coddingtonbear/suzibot/hardware/suzie_bot.pdf

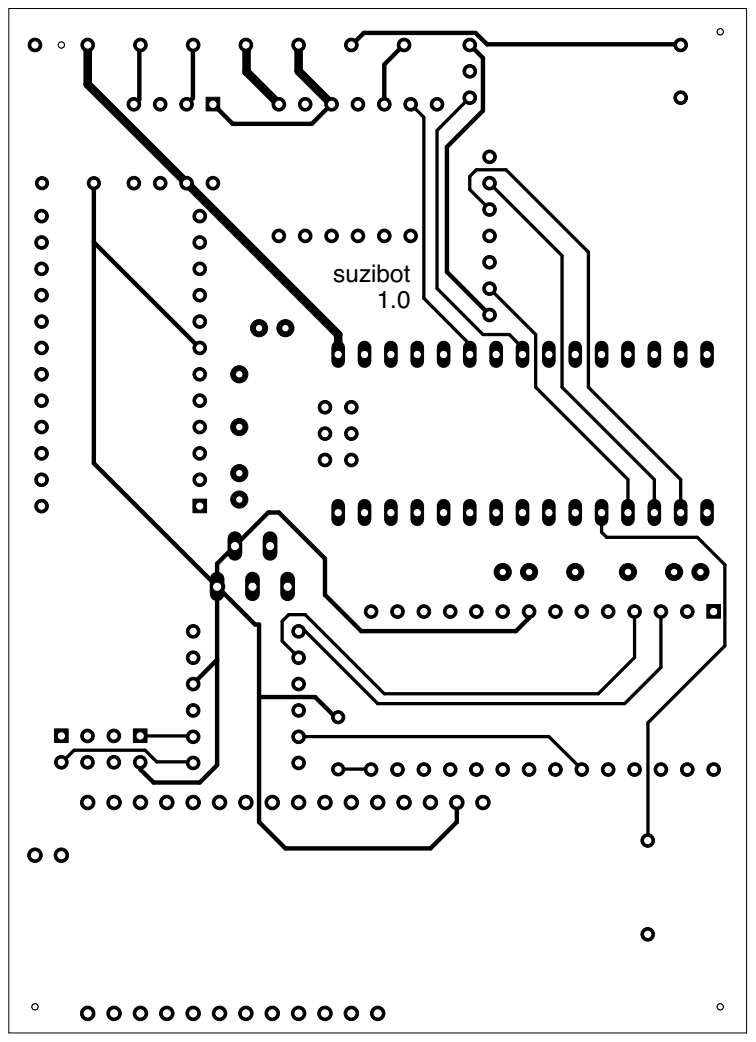
[picture p1: page 1]
