coddingtonbear/suzibot/hardware/suzie_bot_bottom.pdf

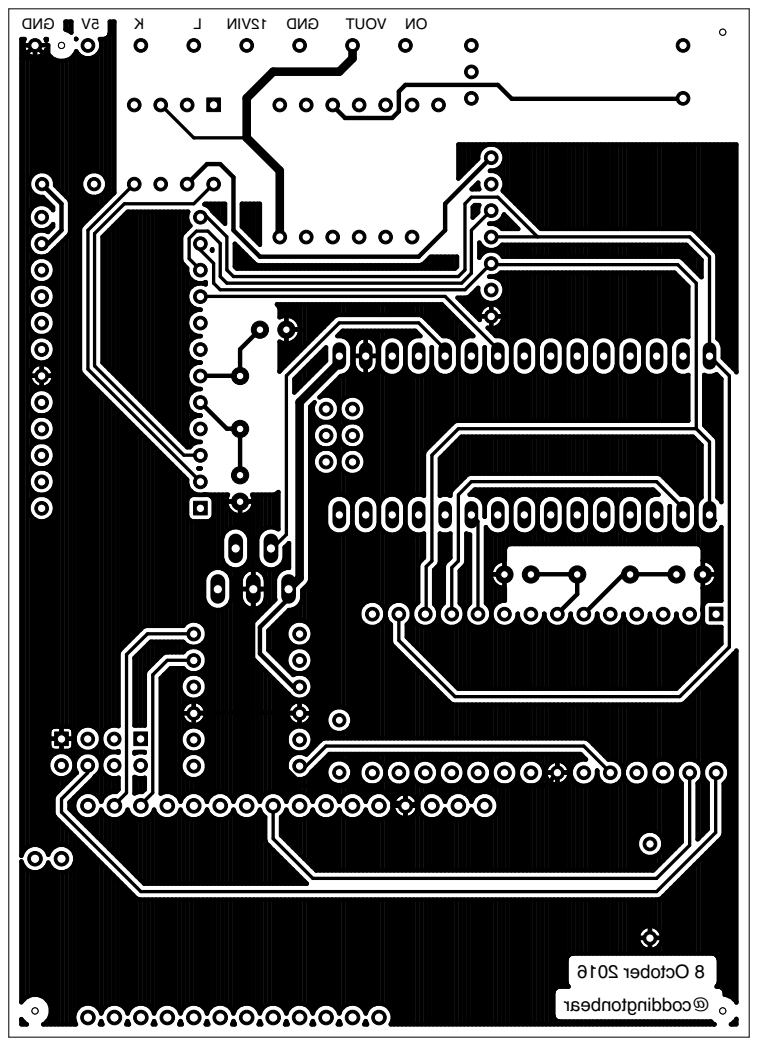
[picture p2: page 1]

DNG V5 K L NI V21 DNG TUOV NO
