coddingtonbear/suzibot/hardware/suzie_bot_top.pdf

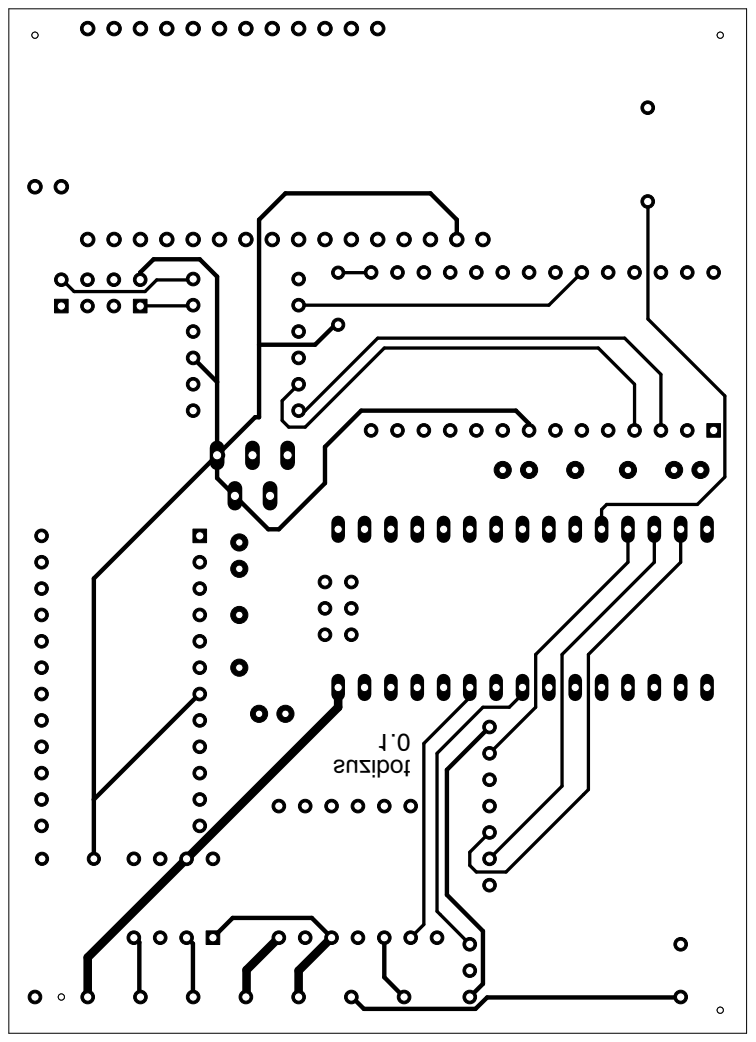
[picture p3: page 1]
