coddingtonbear/suzibot/hardware/shield/shield.kicad_pcb

## KiCad design hardware/shield/shield.kicad_pcb (2016-12-24)

Schematic: shield.sch

Parts:
C1, C2: 22p; C_0805_HandSoldering
C3: 0.01u; C_0805_HandSoldering
C4: 22u; C_Radial_D5_L6_P2.5
C5, C6, C7, C8: 0.1u; C_0805_HandSoldering
D1: ORANGE; LED_0805
D2: RED; LED_0805
D3: BLUE; LED_0805
E1: JNHUAMAO_HM-10; JNHUAMAO_26.9X13X2.2_BOARD
J10: USB_OTG; USB_Mini-B
JP1, JP2: Pin_Header_Straight_1x03
PA0, PA1: DP_DEVICES.V6_M1X8
PB0, PB1: DP_DEVICES.V6_M1X8
PC0, PC1: DP_DEVICES.V6_M1X8
PD0, PD1: DP_DEVICES.V6_M1X8
PROG0, PROG1: DP_DEVICES.V6_M1X6
PWR0, PWR1, PWR2, PWR3: DP_DEVICES.V6_M1X3
R1: 68; R_0805_HandSoldering
R2: 150; R_0805_HandSoldering
R3: 100; R_0805_HandSoldering
R4: DTR-RST; C_0805
R5: RTS-RST; C_0805
R6: 3V3USB; C_0805
SW1: RESET; NANO-SWITCH
U1: LM1117; SPARKFUN-POWERIC_SOT223
U2: 74LV4052; SOIC-16_3.9x9.9mm_Pitch1.27mm
U3: TXB0104; SOIC-14_3.9x8.7mm_Pitch1.27mm
U$1: CH340G_SOIC16
Y1: 12M; Crystal_HC49-U_Vertical

Connections:
/3V3: C7.1, E1.11 (RESET), E1.12 (+3.3V), JP1.1, JP2.1, R6.2, U1.2 (OUT), U1.4 (OUT), U3.1 (VA), U3.8 (OE)
/CONN-BT: E1.24 (LED), U3.5 (A4)
/D-: J10.2 (D-), U$1.6 (D-)
/DTR: PROG0.1, PROG1.1, R4.2, R5.2, SW1.1, U3.11 (B3)
/DTR-BT: E1.25 (PIO2), U3.4 (A3)
/DTR-USB: R4.1, U$1.13 (DTR)
/N$2: JP1.3, JP2.3, PWR0.2, PWR1.2, R1.1
/N$6: J10.1 (VBUS), PROG0.4, PROG1.4
/N$8: C3.2, R6.1, U$1.4 (V3)
/N$9: PD0.8, PD1.8
/N$10: PD0.7, PD1.7
/N$11: PD0.6, PD1.6
/N$12: PD0.5, PD1.5
/N$13: PD0.4, PD1.4
/N$14: PD0.3, PD1.3
/N$15: PD0.2, PD1.2
/N$16: PD0.1, PD1.1
/N$17: PC0.8, PC1.8
/N$18: PC0.7, PC1.7
/N$19: PC0.6, PC1.6
/N$20: PROG0.5, PROG1.5
/N$21: PC0.4, PC1.4, R3.2, U2.10 (A0), U3.10 (B4)
/N$22: PC0.3, PC1.3
/N$23: PC0.2, PC1.2
/N$24: PC0.1, PC1.1
/N$25: PB0.8, PB1.8
/N$26: PB0.7, PB1.7
/N$27: PB0.6, PB1.6
/N$28: PB0.5, PB1.5
/N$29: PB0.4, PB1.4
/N$30: PB0.3, PB1.3
/N$31: PB0.2, PB1.2
/N$32: PB0.1, PB1.1
/N$33: PA0.8, PA1.8
/N$34: PA0.7, PA1.7
/N$35: PA0.6, PA1.6
/N$36: PA0.5, PA1.5
/N$37: PA0.4, PA1.4
/N$38: PA0.3, PA1.3
/N$39: PA0.2, PA1.2
/N$40: PA0.1, PA1.1
/N$44: JP1.2, PWR3.2
/N$45: JP2.2, PWR2.2
/PB: PC0.5, PC1.5
/RX: PROG0.2, PROG1.2, U2.13 (X)
/RXD-CH340G: U2.12 (X0), U$1.3 (RX)
/TX: PROG0.3, PROG1.3, U2.3 (Y)
/TXD-CH340G: U2.1 (Y0), U$1.2 (TX)
/XI: C1.1, U$1.7 (XI), Y1.2
/XO: C2.1, U$1.8 (XO), Y1.1
D+: J10.3 (D+), U$1.5 (D+)
GND: C1.2, C2.2, C3.1, C4.2, C5.2, C6.2, C7.2, C8.2, D1.1 (K), D2.1 (K), D3.1 (K), E1.13 (GND), E1.14 (GND), E1.21 (GND), E1.22 (GND), J10.5 (GND), PROG0.6, PROG1.6, PWR0.1, PWR1.1, PWR2.1, PWR3.1, U1.1 (ADJ), U2.6 (~E), U2.7 (VEE), U2.8 (Vss), U2.9 (A1), U3.7 (GND), U$1.1 (GND)
unnamed: D1.2 (A), R1.2
unnamed: D2.2 (A), R2.2
unnamed: D3.2 (A), R3.1
unnamed: E1.1 (UART_TX), U3.2 (A1)
unnamed: E1.2 (UART_RX), U3.3 (A2)
unnamed: R5.1, U$1.14 (RTS)
unnamed: U2.5 (Y1), U3.13 (B1)
unnamed: U2.14 (X1), U3.12 (B2)
Vdd: C4.1, C5.1, C6.1, C8.1, PWR0.3, PWR1.3, PWR2.3, PWR3.3, R2.1, SW1.2, U1.3 (IN), U2.16 (Vdd), U3.14 (VB), U$1.16 (VCC)

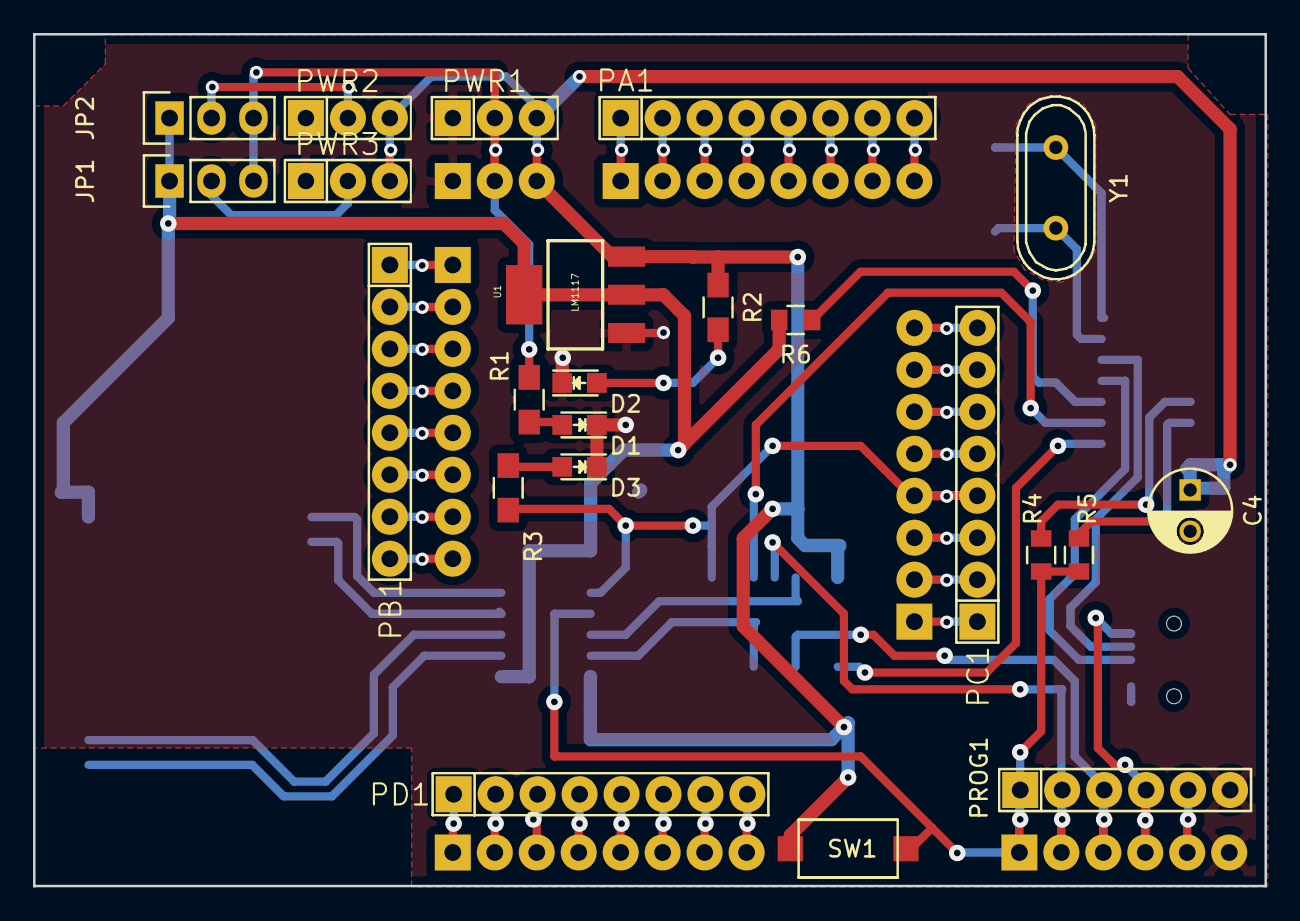
[picture p4: board shield.kicad_pcb from above]

Board: 2 copper layers, 74.5 x 51.6 mm, 41 parts (0 on the bottom side), 61 nets.
