coddingtonbear/suzibot/hardware/suzie_bot.brd

## EAGLE design hardware/suzie_bot.brd (2016-11-30)

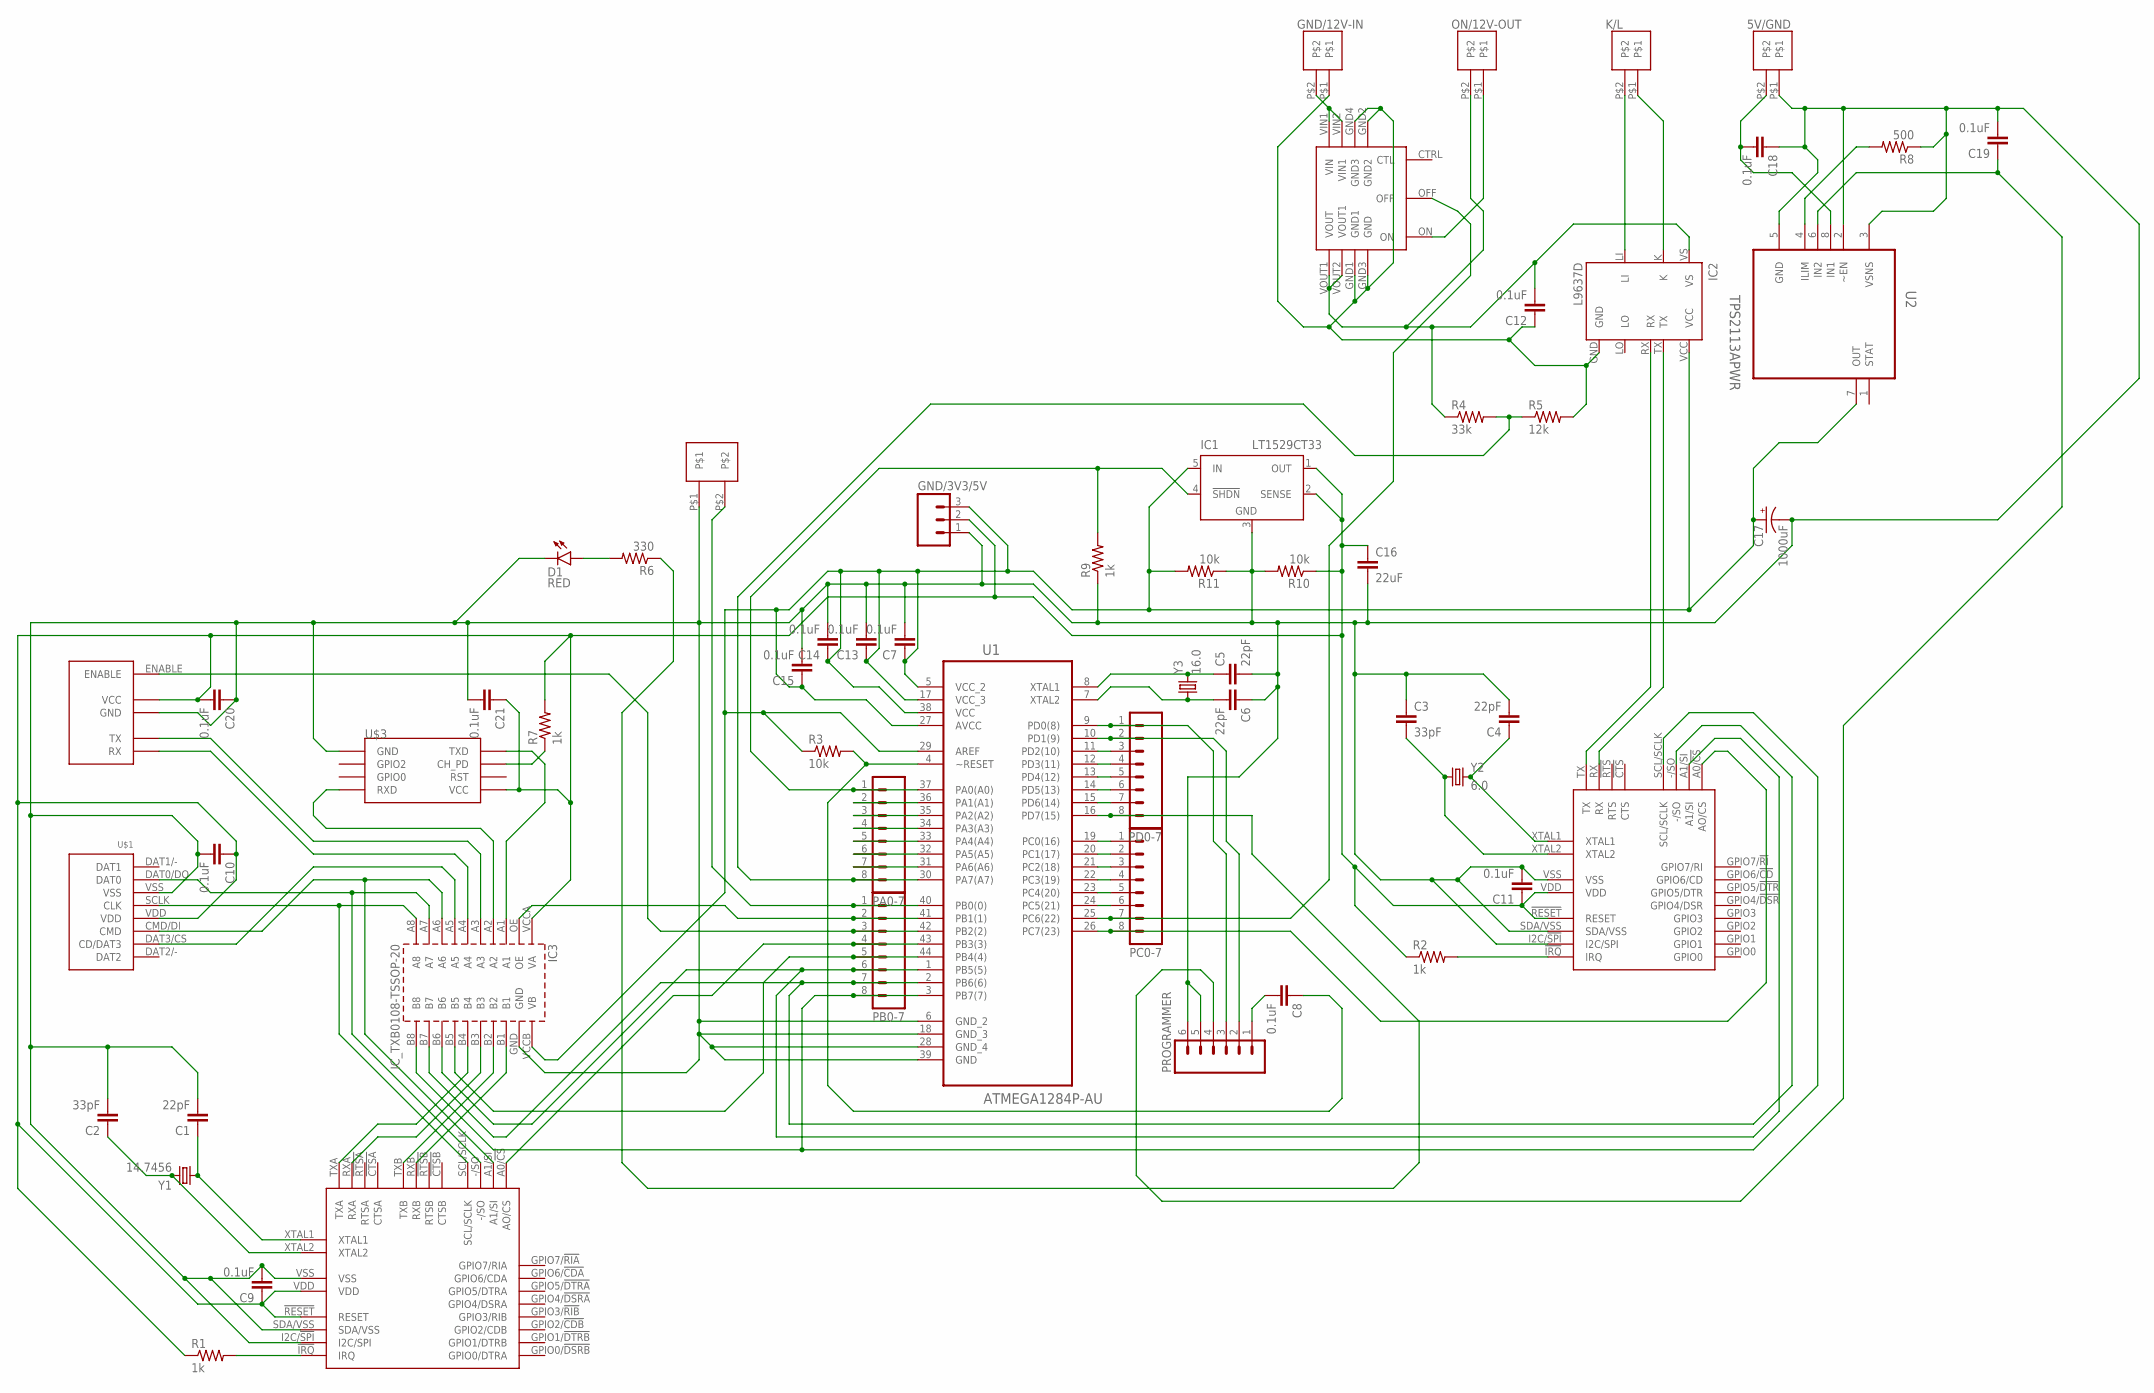
[picture p5: schematic suzie_bot.sch]

Parts:
5V/GND: 2-PIN-TERMINAL
C1, C4, C5, C6: 22pF; 0805
C2, C3: 33pF; 0805
C7, C9, C10, C11, C12, C13, C14, C15, C18, C19, C20, C21: 0.1uF; 0603-CAP
C8: 0.1uF; 0805
C16: 22uF; 1206
C17: 1000uF; PANASONIC_G
D1: RED; LED5MM
GND/3V3/5V: M03PTH; 1X03
GND/12V-IN: 2-PIN-TERMINAL
IC1: LT1529CT33; TO220-5
IC2: L9637D; SO08
IC3: IC_TXB0108-TSSOP-20; TSSOP-20
K/L: 2-PIN-TERMINAL
ON/12V-OUT: 2-PIN-TERMINAL
PA0-7: M08; 1X08_ROUND
PB0-7: M08; 1X08_ROUND
PC0-7: M08; 1X08_ROUND
PD0-7: M08; 1X08_ROUND
PROGRAMMER: M06SILK_FEMALE_PTH; 1X06
R1, R2, R7, R9: 1k; 0805
R3, R10, R11: 10k; 0805
R4: 33k; 0805
R5: 12k; 0805
R6: 330; 0805
R8: 500; 0805
U1: ATMEGA1284P-AU; QFP80P1200X1200X120-44N
U2: TPS2113APWR; SOP65P640X120-8N
U$1: CON_MICROSDHINGED; CON_MICROSD_HINGED
U$2: SC16IS752IPW; TSSOP28
U$3: ESP01
U$4: MINI
U$5: FEATHERWING
U$7: SC16IS750IPW; TSSOP-24
U$11: PIEZO; 17MM-PIEZO
Y1: 14.7456; HC49US
Y2: 6.0; HC49US
Y3: 16.0; HC49US

Connections:
3V3: C9.1, C10.1, C11.1, C16.1, C20.2, C21.1, GND/3V3/5V.2, IC1.1 (OUT), IC1.2 (SENSE), IC3.VCCA (VA), R1.1, R2.1, R7.2, R10.1, U$1.VDD, U$2.!RESET (RESET), U$2.VDD, U$3.VCC, U$5.VCC, U$7.!RESET (RESET), U$7.VDD
5V: C7.1, C13.1, C14.1, C15.1, C17.+, GND/3V3/5V.3, IC1.5 (IN), IC2.VCC, IC3.VCCB (VB), R3.1, R11.2, U1.5 (VCC_2), U1.17 (VCC_3), U1.27 (AVCC), U1.29 (AREF), U1.38 (VCC), U2.7 (OUT)
12V-OUT: C12.2, IC2.VS, ON/12V-OUT.P$2, R4.1, U$4.VOUT1 (VOUT), U$4.VOUT2 (VOUT1)
EXTGND: C12.1, GND/12V-IN.P$1, IC2.GND, R5.2, U$4.GND1, U$4.GND2, U$4.GND3 (GND), U$4.GND4 (GND3)
GND: 5V/GND.P$1, C1.2, C2.2, C3.1, C4.2, C5.2, C6.1, C7.2, C9.2, C10.2, C11.2, C13.2, C14.2, C15.2, C16.2, C17.-, C18.1, C19.2, C20.1, C21.2, D1.K (C), GND/3V3/5V.1, IC1.3 (GND), IC3.GND, PROGRAMMER.5, PROGRAMMER.6, R8.1, R9.1, R10.2, R11.1, U1.6 (GND_2), U1.18 (GND_3), U1.28 (GND_4), U1.39 (GND), U2.2 (~EN), U2.3 (VSNS), U2.5 (GND), U$1.VSS, U$2.I2C/!SPI (I2C/SPI), U$2.SDA/VSS, U$2.VSS, U$3.GND, U$5.GND, U$7.I2C/!SPI (I2C/SPI), U$7.SDA/VSS, U$7.VSS, U$11.P$1
K: IC2.K, K/L.P$1
L: IC2.LI, K/L.P$2
MISO3V3: IC3.A7, U$1.DAT0/DO (DAT0), U$2.-/SO
MOSI3V3: IC3.A6, U$1.CMD/DI (CMD), U$2.A1/SI
unnamed: C1.1, U$2.XTAL1, Y1.1
unnamed: D1.A, R6.2
unnamed: C2.1, U$2.XTAL2, Y1.2
unnamed: R7.1, U$3.CH_PD
unnamed: IC3.A1, U$3.TX (TXD)
unnamed: C6.2, U1.7 (XTAL2), Y3.1
unnamed: GND/12V-IN.P$2, U$4.VIN1 (VIN), U$4.VIN2 (VIN1)
unnamed: IC3.A2, U$3.RX (RXD)
unnamed: C5.1, U1.8 (XTAL1), Y3.2
unnamed: C8.2, PROGRAMMER.1
unnamed: IC3.B1, U$2.RXB
unnamed: IC3.B2, U$2.TXB
unnamed: C8.1, R3.2, U1.4 (~RESET)
unnamed: IC3.A4, U$5.RX-2 (RX)
unnamed: IC2.RX, U$7.TX
unnamed: R2.2, U$7.!IRQ (IRQ)
unnamed: IC3.B3, U$2.RXA
unnamed: R1.2, U$2.!IRQ (IRQ)
unnamed: IC2.TX, U$7.RX
unnamed: C4.1, U$7.XTAL1, Y2.2
unnamed: C3.2, U$7.XTAL2, Y2.1
unnamed: IC3.A3, U$5.TX-2 (TX)
unnamed: IC3.B4, U$2.TXA
unnamed: IC3.A5, U$1.DAT3/CS (CD/DAT3)
unnamed: IC3.OE, PB0-7.2, U1.41 (PB1(1))
unnamed: IC3.B5, PB0-7.5, U1.44 (PB4(4))
unnamed: PA0-7.7, U1.31 (PA6(A6))
unnamed: PA0-7.6, U1.32 (PA5(A5))
unnamed: C19.1, PROGRAMMER.4, U2.6 (IN2)
unnamed: R8.2, U2.4 (ILIM)
unnamed: 5V/GND.P$2, C18.2, U2.8 (IN1)
N$PD0/RXD0: PD0-7.1, PROGRAMMER.3, U1.9 (PD0(8))
PA0: IC1.4 (!SHDN), PA0-7.1, R9.2, U1.37 (PA0(A0))
PA1: PA0-7.2, U1.36 (PA1(A1))
PA2: PA0-7.3, U1.35 (PA2(A2))
PA3: PA0-7.4, U1.34 (PA3(A3))
PA4: PA0-7.5, U1.33 (PA4(A4))
PA7: PA0-7.8, R4.2, R5.1, U1.30 (PA7(A7))
PB0: PB0-7.1, U1.40 (PB0(0)), U$11.P$2
PB2: PB0-7.3, U1.42 (PB2(2)), U$5.ENABLE
PB3: PB0-7.4, U1.43 (PB3(3)), U$2.A0/!CS (AO/CS)
PB5/MOSI: IC3.B6, PB0-7.6, U1.1 (PB5(5)), U$7.A1/SI
PB6/MISO: IC3.B7, PB0-7.7, U1.2 (PB6(6)), U$7.-/SO
PB7/SCLK: IC3.B8, PB0-7.8, U1.3 (PB7(7)), U$7.SCL/SCLK
PC0: PC0-7.1, U1.19 (PC0(16))
PC1: PC0-7.2, U1.20 (PC1(17))
PC2: PC0-7.3, U1.21 (PC2(18))
PC3: PC0-7.4, U1.22 (PC3(19))
PC4: PC0-7.5, U1.23 (PC4(20))
PC5: PC0-7.6, U1.24 (PC5(21))
PC6: PC0-7.7, U1.25 (PC6(22)), U$4.OFF
PC7: PC0-7.8, U1.26 (PC7(23)), U$7.A0/!CS (AO/CS)
PD1/TXD0: PD0-7.2, PROGRAMMER.2, U1.10 (PD1(9))
PD2/RXD1: PD0-7.3, U1.11 (PD2(10))
PD3/TXD1: PD0-7.4, U1.12 (PD3(11))
PD4: PD0-7.5, U1.13 (PD4(12))
PD5: PD0-7.6, U1.14 (PD5(13))
PD6: PD0-7.7, U1.15 (PD6(14))
PD7: PD0-7.8, R6.1, U1.16 (PD7(15))
POWERON: ON/12V-OUT.P$1, U$4.ON
SKCK3V3: IC3.A8, U$1.SCLK (CLK), U$2.SCL/SCLK

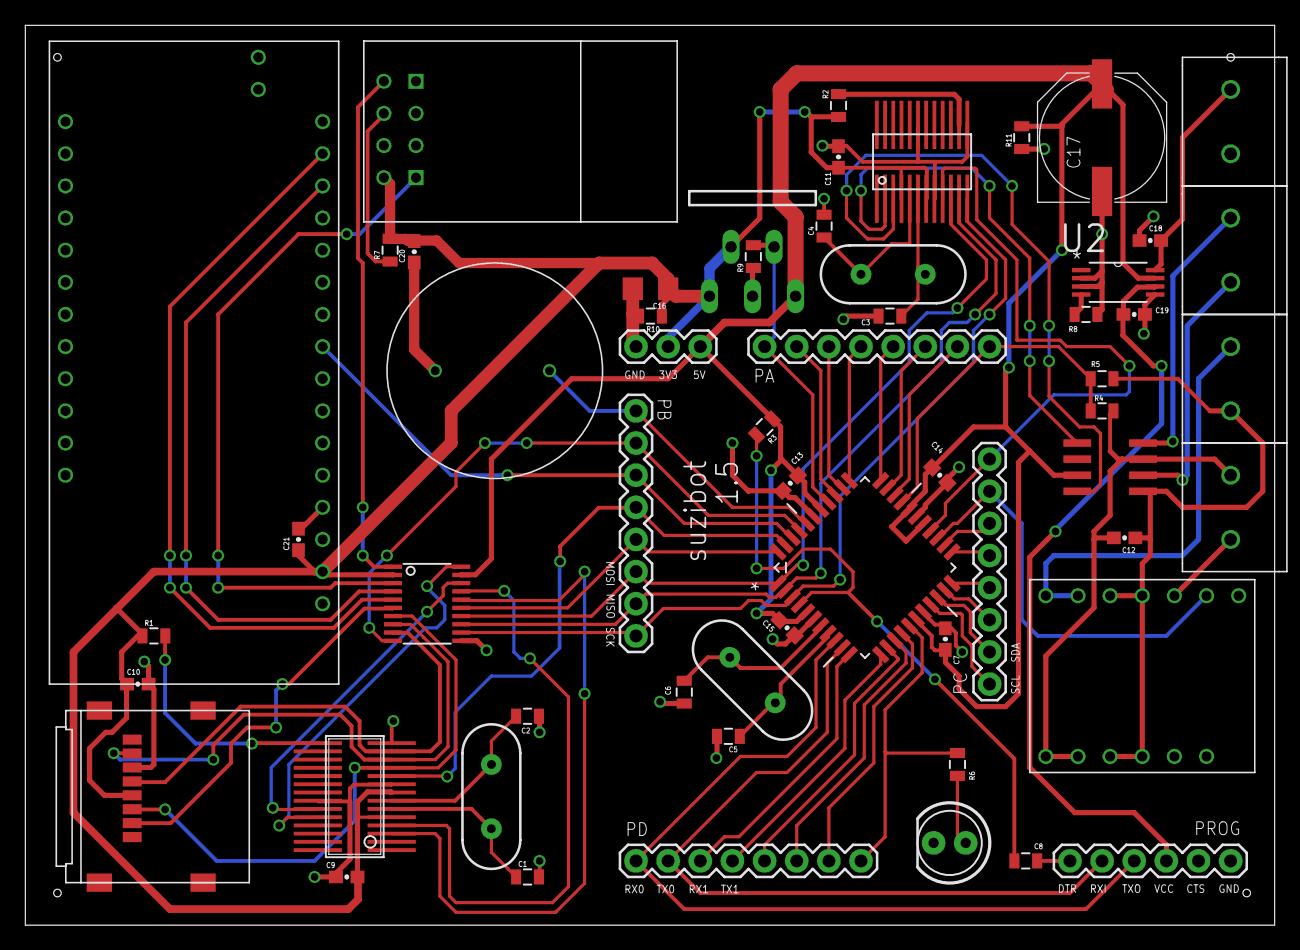
[picture p6: board suzie_bot.brd from above]

Board: 2 copper layers, 98.7 x 71.1 mm, 58 parts (0 on the bottom side), 70 nets.
