coddingtonbear/suzibot/software/src/pins.h

#pragma once

#define PIN_PB0 0
#define PIN_PB1 1
#define PIN_PB2 2
#define PIN_PB3 3
#define PIN_PB4 4
#define PIN_PB5 5
#define PIN_PB6 6
#define PIN_PB7 7

#define PIN_PD0 8
#define PIN_PD1 9
#define PIN_PD2 10
#define PIN_PD3 11
#define PIN_PD4 12
#define PIN_PD5 13
#define PIN_PD6 14
#define PIN_PD7 15

#define PIN_PC0 16
#define PIN_PC1 17
#define PIN_PC2 18
#define PIN_PC3 19
#define PIN_PC4 20
#define PIN_PC5 21
#define PIN_PC6 22
#define PIN_PC7 23

#define PIN_PA0 A0
#define PIN_PA1 A1
#define PIN_PA2 A2
#define PIN_PA3 A3
#define PIN_PA4 A4
#define PIN_PA5 A5
#define PIN_PA6 A6
#define PIN_PA7 A7
