coddingtonbear/suzibot/(commit log)

2016-09-26 And so it begins.
    [suzie_bot.brd, suzie_bot.sch]
2016-09-28 Latest attempts.
    [suzie_bot.brd, suzie_bot.sch]
2016-10-01 Another iteration.
    [suzie_bot.brd]
2016-10-02 Totally working. IT WAS VOLTAGE LEVELS AND CRYSTAL CAPACITANCE PROBLEMS ALL ALONG.
    [suzie_bot.brd, suzie_bot.sch]
2016-10-07 Basic working features.
    [suzie_bot.brd, suzie_bot.sch]
2016-10-08 Adding a ground plane at @nbanerje's suggestion. Thanks @nbanerje!
    [suzie_bot.brd, suzie_bot.sch]
2016-10-08 Minor changes to improve positioning.
    [suzie_bot.brd]
2016-10-08 Some routing alterations; fixing SD card package sizing.
    [suzie_bot.brd, suzie_bot.sch]
2016-10-08 Routing a bunch of wires further from the pins.
    [suzie_bot.brd]
2016-10-08 Adding some text.
    [suzie_bot.brd]
2016-10-09 Updating board and schematic.
    [suzie_bot.brd, suzie_bot.sch]
2016-10-10 Updating board.
    [suzie_bot.brd, suzie_bot.sch]
2016-10-10 Moving voltage sensor slightly closer to edge.
    [suzie_bot.brd]
2016-10-16 SMD-ized; pre-autorouting.
    [suzie_bot.brd, suzie_bot.sch]
2016-10-17 Fully layed-out.
    [suzie_bot.brd, suzie_bot.sch]
2016-10-17 Updating to include missing connection to Vout.
    [suzie_bot.brd, suzie_bot.sch]
2016-10-17 Adding LED to PB1 (per https://www.flickr.com/photos/maniacbug/6413368937/)
    [suzie_bot.brd, suzie_bot.sch]
2016-11-01 Updating to v1.3 boardfile (what was once an atmega328p is now an atmega1284p)
    [suzie_bot.brd, suzie_bot.sch]
2016-11-07 Much better decoupling; adding TI TPS2113A for limiting inrush current.
    [suzie_bot.brd, suzie_bot.sch]
2016-11-08 Start board with 3V3 rail disabled; enable after ~1s (long enough for caps to charge)
2016-11-08 Add assertion/deassertion of SPI bus for SD card interactions.
2016-11-08 Adding 1k pullup resistor for disabling 3V3 regulator until MC-enabled.
    [suzie_bot.brd, suzie_bot.sch]
2016-11-30 Minor build changes; switching back to high-speed SPI.
2016-11-30 Updating to latest board version.
    [suzie_bot.brd, suzie_bot.sch]
2016-11-30 Switch to pin names rather than using artificially-assigned mightycore pin numbers.
2016-11-30 Adding ArduinoJson and EventManager.
2016-12-04 Switching from .ino format to .cpp/.h
2016-12-06 Move LED lighting into system manager.
2016-12-21 Adding new 'suzibot-shield' subproject.
    [shield.kicad_pcb, shield.sch]
2016-12-22 New version of shield.
    [shield.kicad_pcb, shield.sch]
2016-12-22 Fully-routed; just the wrong size.
    [shield.kicad_pcb, shield.sch]
2016-12-23 Fully routed and with parts in reasonably OK spots.
    [shield.kicad_pcb, shield.sch]
2016-12-24 Fully working; switched to USB MINI B.
    [shield.kicad_pcb, shield.sch]
